Carpelos/Proyecto-Alicia/Caja Acrílica/pie.stl

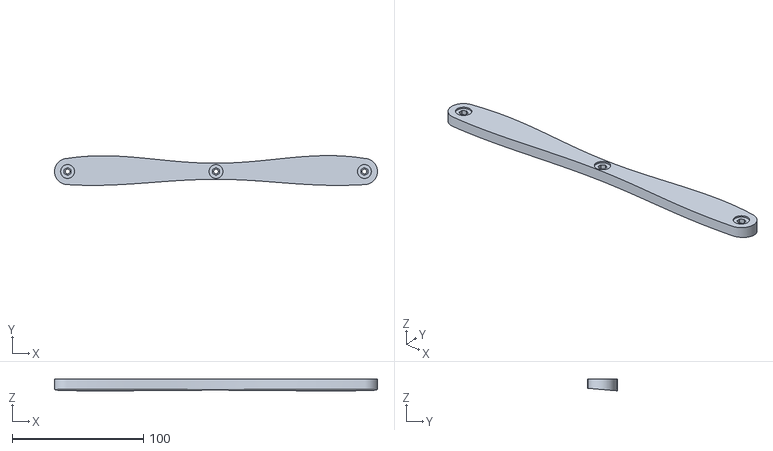
[picture p1: CAD file, 2020-08-05]
Caja Acrílica/pie.stl
246.2 x 22.7 x 8.98
