Carpelos/Proyecto-Alicia/Caja Acrílica/Poverty Alice_2_Plate.dxf

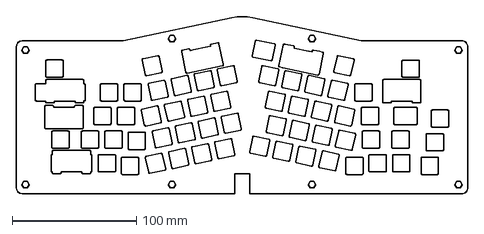
[picture p2: CAD file, 2020-07-27]
Caja Acrílica/Poverty Alice_2_Plate.dxf
364.2 x 143.2 mm
