Carpelos/Proyecto-Alicia/(list of files, cad)

Other CAD files:
Caja Acrílica/Caja Alicia.dwg
Caja Acrílica/bottom.dwg
Caja Acrílica/Poverty Alice_2 en plancha de 1216x660.dwg
Caja Acrílica/Poverty Alice_2.dwg
Caja Acrílica/Poverty Alice_2_Plate.dwg
