Carpelos/Proyecto-Alicia/pcb/Proyecto A.kicad_pcb

## KiCad design pcb/Proyecto A.kicad_pcb (2020-07-28)

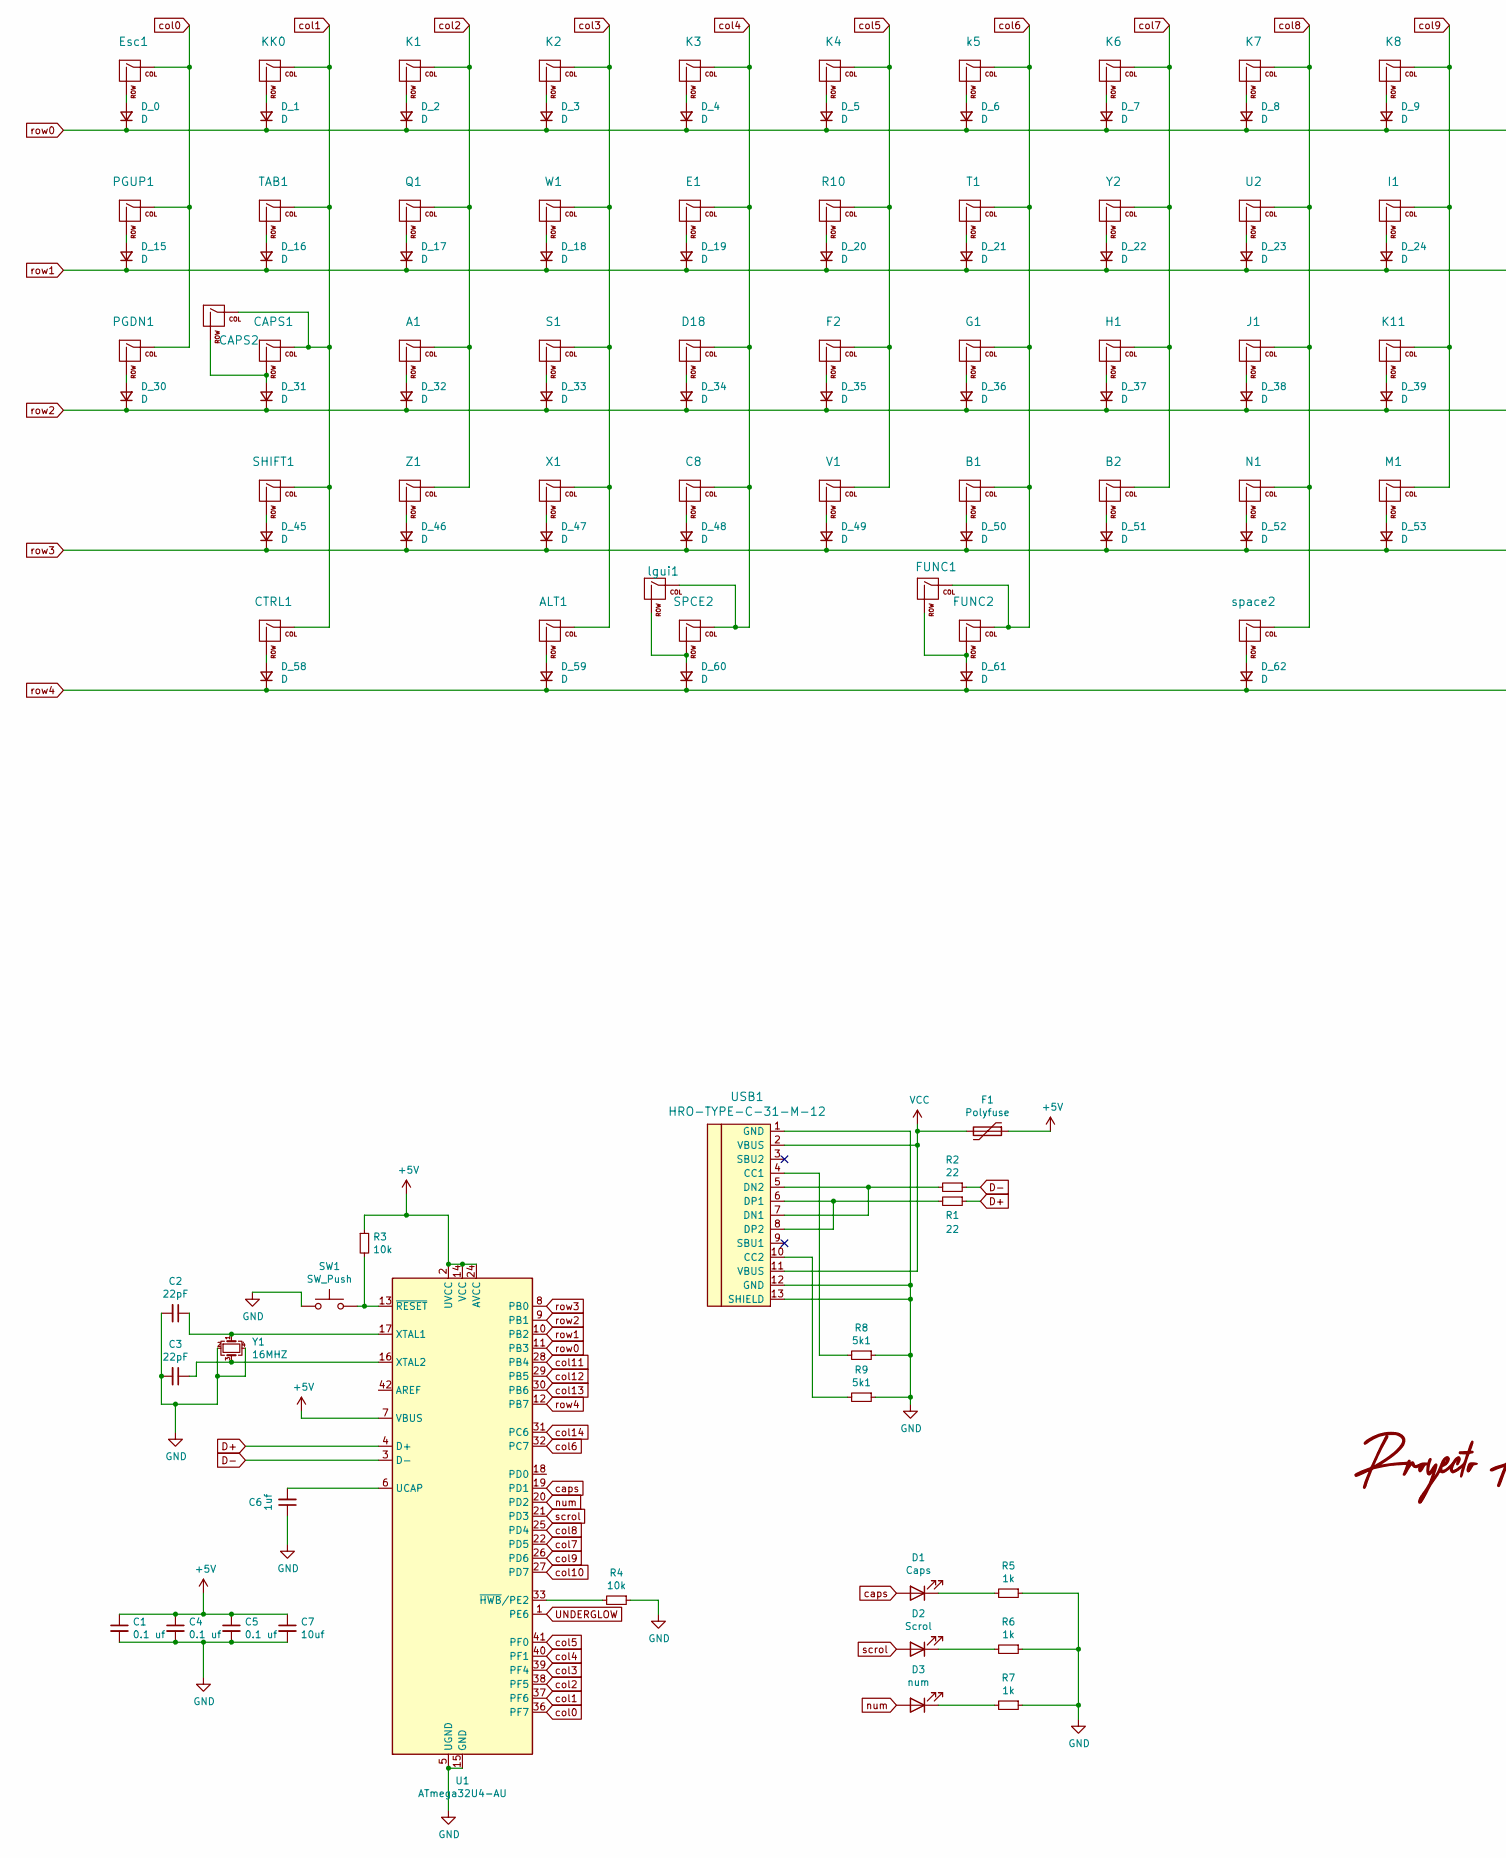
[picture p3: schematic Proyecto A.sch, part in row 1, column 1]

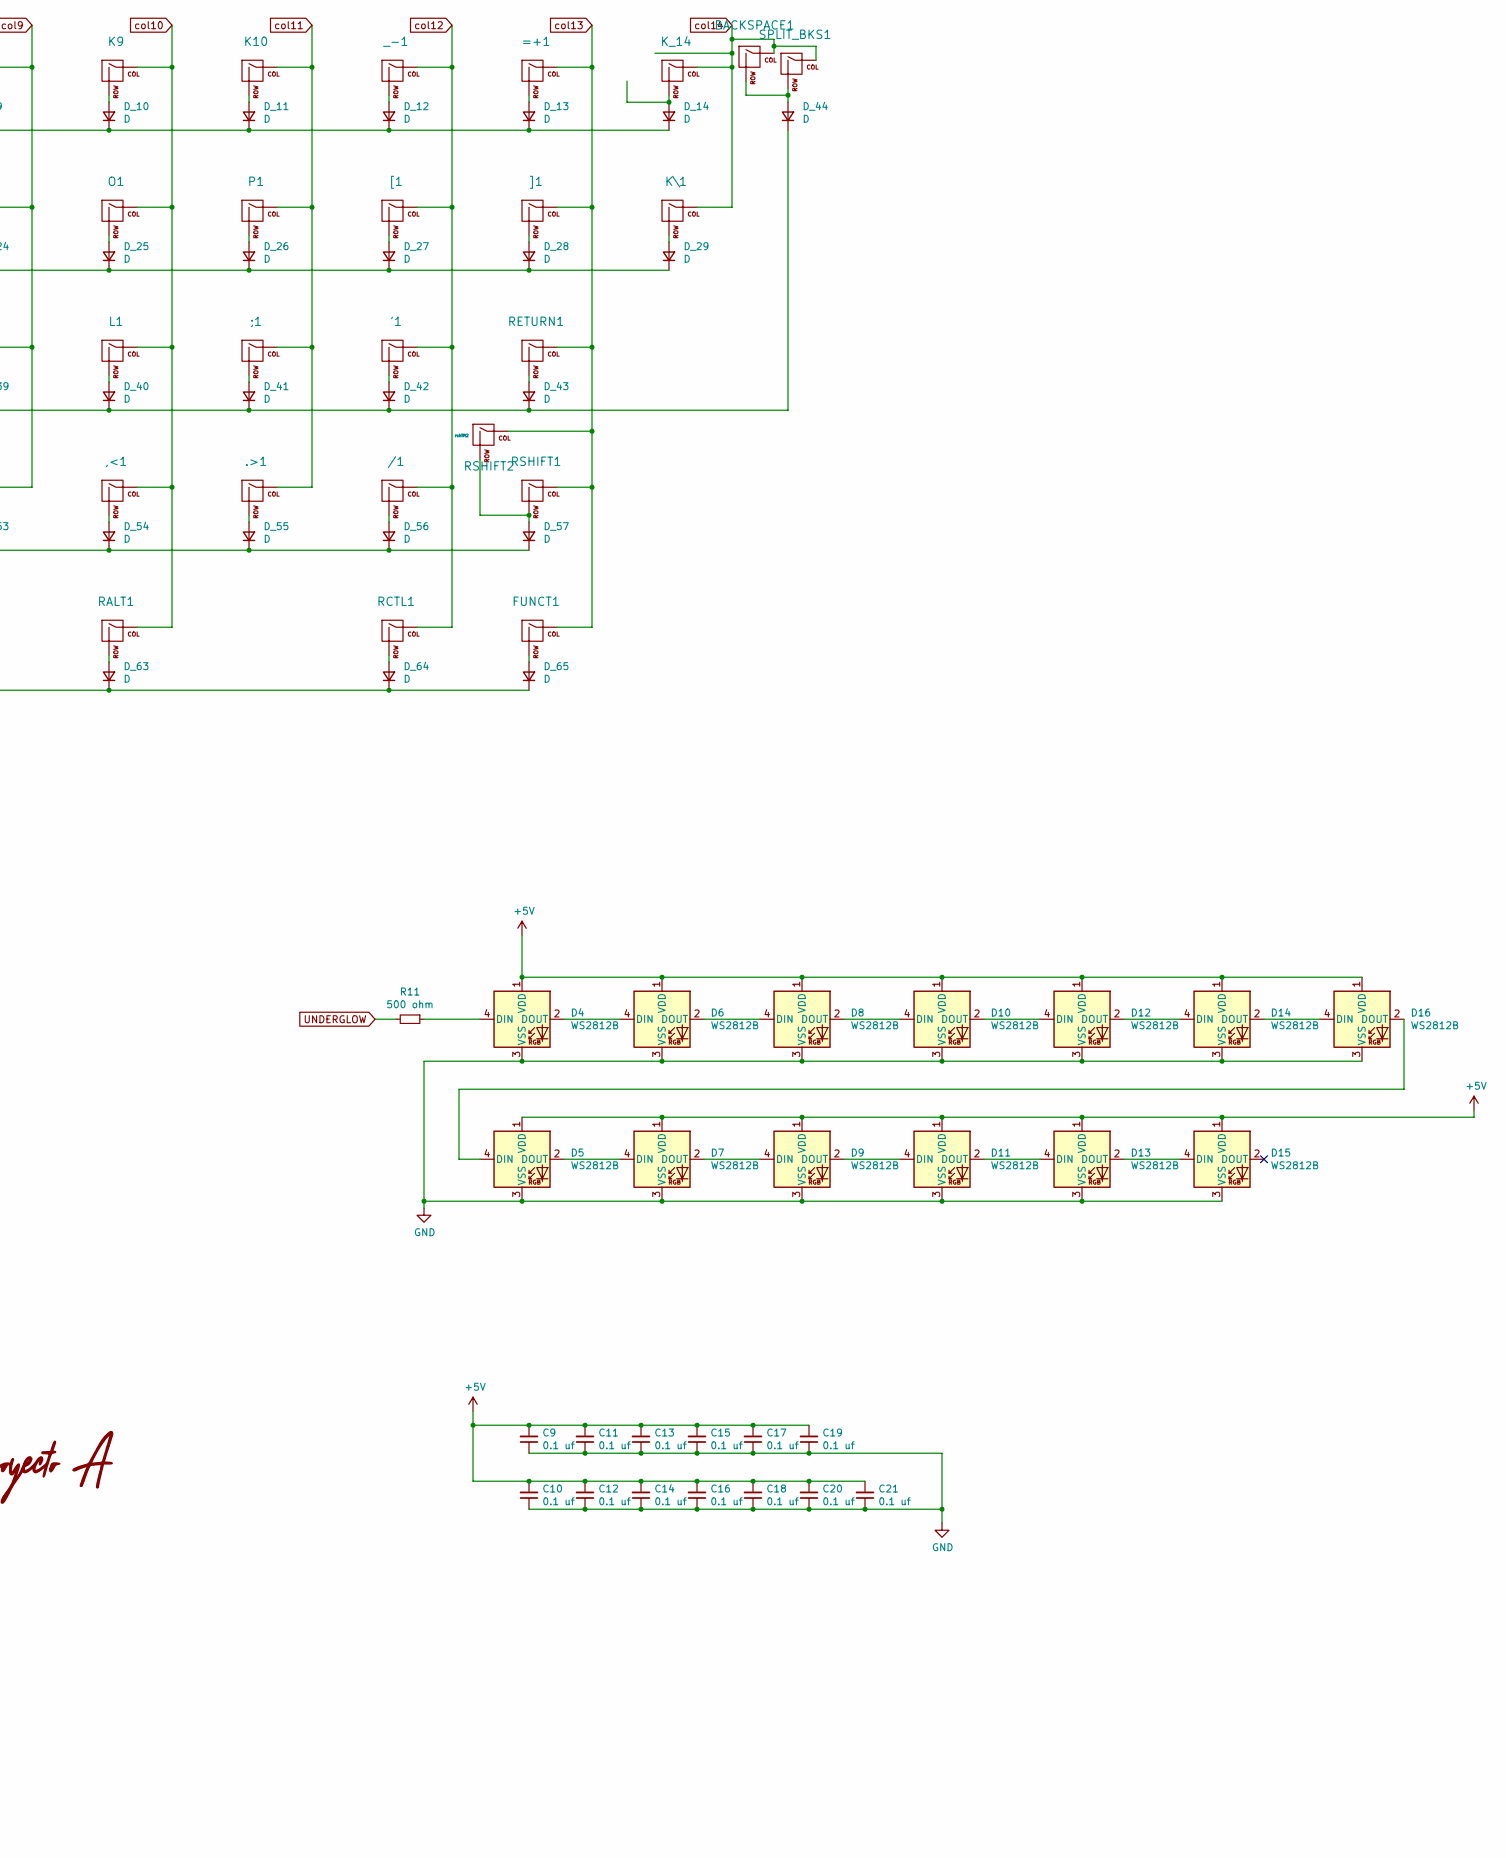
[picture p4: schematic Proyecto A.sch, part in row 1, column 2]

Parts:
'1: '; MXOnly-1U-NoLED
,<1: ,<; MXOnly-1U-NoLED
.>1: .>; MXOnly-1U-NoLED
/1: /; MXOnly-1U-NoLED
;1: ;; MXOnly-1U-NoLED
=+1: =; MXOnly-1U-NoLED
A1: a; MXOnly-1U-NoLED
ALT1: lalt; MXOnly-1.5U-NoLED
B1: b; MXOnly-1U-NoLED
B2: b2; MXOnly-1U-NoLED
BACKSPACE1: backspace; MXOnly-2U-NoLED
C1, C4, C5, C9, C10, C11, C12, C13, C14, C15, C16, C17, C18, C19, C20, C21: 0.1 uf; C_0805_2012Metric_Pad1.15x1.40mm_HandSolder
C2, C3: 22pF; C_0805_2012Metric_Pad1.15x1.40mm_HandSolder
C6: 1uf; C_0805_2012Metric_Pad1.15x1.40mm_HandSolder
C7: 10uf; C_0805_2012Metric_Pad1.15x1.40mm_HandSolder
C8: c; MXOnly-1U-NoLED
CAPS1: caps1; MXOnly-1.75U-NoLED
CAPS2: stcaps; MXOnly-1U-NoLED
CTRL1: lctrl; MXOnly-1.5U-NoLED
D1: Caps; LED_1206_3216Metric_Pad1.42x1.75mm_HandSolder
D2: Scrol; LED_1206_3216Metric_Pad1.42x1.75mm_HandSolder
D3: num; LED_1206_3216Metric_Pad1.42x1.75mm_HandSolder
D4, D5, D6, D7, D8, D9, D10, D11, D12, D13, D14, D15, D16: WS2812B; LED_WS2812B_PLCC4_5.0x5.0mm_P3.2mm
D18: d; MXOnly-1U-NoLED
D_0, D_1, D_2, D_3, D_4, D_5, D_6, D_7, D_8, D_9, D_10, D_11, D_12, D_13, D_14, D_15, D_16, D_17, D_18, D_19, D_20, D_21, D_22, D_23, D_24, D_25, D_26, D_27, D_28, D_29, D_30, D_31, D_32, D_33, D_34, D_35, D_36, D_37, D_38, D_39, D_40, D_41, D_42, D_43, D_44, D_45, D_46, D_47, D_48, D_49, D_50, D_51, D_52, D_53, D_54, D_55, D_56, D_57, D_58, D_59, D_60, D_61, D_62, D_63, D_64, D_65: D; D_SOD-123; JLC C64898
E1: e; MXOnly-1U-NoLED
Esc1: KEYSW; MXOnly-1U-NoLED
F1: Polyfuse; Fuse_1206_3216Metric
F2: f; MXOnly-1U-NoLED
FUNC1: func1; MXOnly-1U-NoLED
FUNC2: func1-2; MXOnly-1.25U-NoLED
FUNCT1: FUNC3; MXOnly-1U-NoLED
G1: g; MXOnly-1U-NoLED
H1: h; MXOnly-1U-NoLED
I1: i; MXOnly-1U-NoLED
J1: j; MXOnly-1U-NoLED
K1: 1; MXOnly-1U-NoLED
K2: 2; MXOnly-1U-NoLED
K3: 3; MXOnly-1U-NoLED
K4: 4; MXOnly-1U-NoLED
K6: 6; MXOnly-1U-NoLED
K7: 7; MXOnly-1U-NoLED
K8: 8; MXOnly-1U-NoLED
K9: 9; MXOnly-1U-NoLED
K10: 10; MXOnly-1U-NoLED
K11: k; MXOnly-1U-NoLED
KK0: ES; MXOnly-1U-NoLED
K\1: \\|; MXOnly-1U-NoLED
K_14: sbackspace; MXOnly-1U-NoLED
L1: l; MXOnly-1U-NoLED
M1: KEYSW; MXOnly-1U-NoLED
N1: n; MXOnly-1U-NoLED
O1: o; MXOnly-1U-NoLED
P1: p; MXOnly-1U-NoLED
PGDN1: KEYSW; MXOnly-1U-NoLED
PGUP1: pgup; MXOnly-1U-NoLED
Q1: q; MXOnly-1U-NoLED
R1, R2: 22; R_0805_2012Metric
R3, R4: 10k; R_0805_2012Metric
R5, R6, R7: 1k; R_0805_2012Metric
R8, R9: 5k1; R_0805_2012Metric
R10: r; MXOnly-1U-NoLED
R11: 500 ohm; R_0805_2012Metric_Pad1.15x1.40mm_HandSolder
RALT1: ralt; MXOnly-1.5U-NoLED
RCTL1: RCTRL; MXOnly-1.5U-NoLED
RETURN1: return; MXOnly-2.25U-ReversedStabilizers-NoLED
RSHIFT1: rshift1; MXOnly-1.75U-NoLED
RSHIFT2: rshift2; MXOnly-2.75U-NoLED
S1: s; MXOnly-1U-NoLED
SHIFT1: lshift; MXOnly-2.25U-NoLED
SPCE2: lgui2; MXOnly-2U-ReversedStabilizers-NoLED
SPLIT_BKS1: sbbackspace2; MXOnly-1U-NoLED
SW1: SW_Push; SW_SPST_SKQG_WithStem
T1: t; MXOnly-1U-NoLED
TAB1: tabulador; MXOnly-1.5U-NoLED
U1: ATmega32U4-AU; TQFP-44_10x10mm_P0.8mm
U2: u; MXOnly-1U-NoLED
USB1: HRO-TYPE-C-31-M-12; HRO-TYPE-C-31-M-12-HandSoldering
V1: v; MXOnly-1U-NoLED
W1: w; MXOnly-1U-NoLED
X1: x; MXOnly-1U-NoLED
Y1: 16MHZ; Crystal_SMD_3225-4Pin_3.2x2.5mm_HandSoldering
Y2: y; MXOnly-1U-NoLED
Z1: z; MXOnly-1U-NoLED
[1: [; MXOnly-1U-NoLED
]1: ]; MXOnly-1U-NoLED
_-1: -; MXOnly-1U-NoLED
k5: 5; MXOnly-1U-NoLED
lgui1: lgui; MXOnly-2.25U-ReversedStabilizers-NoLED
space2: KEYSW; MXOnly-2.75U-ReversedStabilizers-NoLED

Connections:
+5V: C1.1, C4.1, C5.1, C7.1, C9.2, C10.2, C11.2, C12.2, C13.2, C14.2, C15.2, C16.2, C17.2, C18.2, C19.2, C20.2, C21.2, D4.1 (VDD), D5.1 (VDD), D6.1 (VDD), D7.1 (VDD), D8.1 (VDD), D9.1 (VDD), D10.1 (VDD), D11.1 (VDD), D12.1 (VDD), D13.1 (VDD), D14.1 (VDD), D15.1 (VDD), D16.1 (VDD), F1.1, R3.1, U1.2 (UVCC), U1.7 (VBUS), U1.14 (VCC), U1.24 (AVCC), U1.34 (VCC), U1.44 (AVCC)
D+: R1.1, U1.4 (D+)
D-: R2.1, U1.3 (D-)
GND: C1.2, C2.2, C3.2, C4.2, C5.2, C6.1, C7.2, C9.1, C10.1, C11.1, C12.1, C13.1, C14.1, C15.1, C16.1, C17.1, C18.1, C19.1, C20.1, C21.1, D4.3 (VSS), D5.3 (VSS), D6.3 (VSS), D7.3 (VSS), D8.3 (VSS), D9.3 (VSS), D10.3 (VSS), D11.3 (VSS), D12.3 (VSS), D13.3 (VSS), D14.3 (VSS), D15.3 (VSS), D16.3 (VSS), R4.1, R5.1, R6.1, R7.1, R8.1, R9.1, SW1.1, U1.5 (UGND), U1.15 (GND), U1.23 (GND), U1.35 (GND), U1.43 (GND), USB1.1 (GND), USB1.12 (GND), USB1.13 (SHIELD), Y1.2, Y1.4
unnamed: '1.2 (ROW), D_42.2 (A)
unnamed: ,<1.2 (ROW), D_54.2 (A)
unnamed: .>1.2 (ROW), D_55.2 (A)
unnamed: /1.2 (ROW), D_56.2 (A)
unnamed: ;1.2 (ROW), D_41.2 (A)
unnamed: =+1.2 (ROW), D_13.2 (A)
unnamed: A1.2 (ROW), D_32.2 (A)
unnamed: ALT1.2 (ROW), D_59.2 (A)
unnamed: B1.2 (ROW), D_50.2 (A)
unnamed: B2.2 (ROW), D_51.2 (A)
unnamed: BACKSPACE1.2 (ROW), D_44.2 (A), SPLIT_BKS1.2 (ROW)
unnamed: C2.1, U1.17 (XTAL1), Y1.1
unnamed: C3.1, U1.16 (XTAL2), Y1.3
unnamed: C6.2, U1.6 (UCAP)
unnamed: C8.2 (ROW), D_48.2 (A)
unnamed: CAPS1.2 (ROW), CAPS2.2 (ROW), D_31.2 (A)
unnamed: CTRL1.2 (ROW), D_58.2 (A)
unnamed: D1.1 (K), R5.2
unnamed: D2.1 (K), R6.2
unnamed: D3.1 (K), R7.2
unnamed: D4.2 (DOUT), D6.4 (DIN)
unnamed: D4.4 (DIN), R11.1
unnamed: D5.2 (DOUT), D7.4 (DIN)
unnamed: D6.2 (DOUT), D8.4 (DIN)
unnamed: D7.2 (DOUT), D9.4 (DIN)
unnamed: D10.2 (DOUT), D12.4 (DIN)
unnamed: D8.2 (DOUT), D10.4 (DIN)
unnamed: D11.2 (DOUT), D13.4 (DIN)
unnamed: D9.2 (DOUT), D11.4 (DIN)
unnamed: D12.2 (DOUT), D14.4 (DIN)
unnamed: D13.2 (DOUT), D15.4 (DIN)
unnamed: D14.2 (DOUT), D16.4 (DIN)
unnamed: D5.4 (DIN), D16.2 (DOUT)
unnamed: D18.2 (ROW), D_34.2 (A)
unnamed: D_0.2 (A), Esc1.2 (ROW)
unnamed: D_1.2 (A), KK0.2 (ROW)
unnamed: D_2.2 (A), K1.2 (ROW)
unnamed: D_3.2 (A), K2.2 (ROW)
unnamed: D_4.2 (A), K3.2 (ROW)
unnamed: D_5.2 (A), K4.2 (ROW)
unnamed: D_6.2 (A), k5.2 (ROW)
unnamed: D_7.2 (A), K6.2 (ROW)
unnamed: D_8.2 (A), K7.2 (ROW)
unnamed: D_9.2 (A), K8.2 (ROW)
unnamed: D_10.2 (A), K9.2 (ROW)
unnamed: D_11.2 (A), K10.2 (ROW)
unnamed: D_12.2 (A), _-1.2 (ROW)
unnamed: D_14.2 (A), K_14.2 (ROW)
unnamed: D_15.2 (A), PGUP1.2 (ROW)
unnamed: D_16.2 (A), TAB1.2 (ROW)
unnamed: D_17.2 (A), Q1.2 (ROW)
unnamed: D_18.2 (A), W1.2 (ROW)
unnamed: D_19.2 (A), E1.2 (ROW)
unnamed: D_20.2 (A), R10.2 (ROW)
unnamed: D_21.2 (A), T1.2 (ROW)
unnamed: D_22.2 (A), Y2.2 (ROW)
unnamed: D_23.2 (A), U2.2 (ROW)
unnamed: D_24.2 (A), I1.2 (ROW)
unnamed: D_25.2 (A), O1.2 (ROW)
unnamed: D_26.2 (A), P1.2 (ROW)
unnamed: D_27.2 (A), [1.2 (ROW)
unnamed: D_28.2 (A), ]1.2 (ROW)
unnamed: D_29.2 (A), K\1.2 (ROW)
unnamed: D_30.2 (A), PGDN1.2 (ROW)
unnamed: D_33.2 (A), S1.2 (ROW)
unnamed: D_35.2 (A), F2.2 (ROW)
unnamed: D_36.2 (A), G1.2 (ROW)
unnamed: D_37.2 (A), H1.2 (ROW)
unnamed: D_38.2 (A), J1.2 (ROW)
unnamed: D_39.2 (A), K11.2 (ROW)
unnamed: D_40.2 (A), L1.2 (ROW)
unnamed: D_43.2 (A), RETURN1.2 (ROW)
unnamed: D_45.2 (A), SHIFT1.2 (ROW)
unnamed: D_46.2 (A), Z1.2 (ROW)
unnamed: D_47.2 (A), X1.2 (ROW)
unnamed: D_49.2 (A), V1.2 (ROW)
unnamed: D_52.2 (A), N1.2 (ROW)
unnamed: D_53.2 (A), M1.2 (ROW)
unnamed: D_57.2 (A), RSHIFT1.2 (ROW), RSHIFT2.2 (ROW)
unnamed: D_60.2 (A), SPCE2.2 (ROW), lgui1.2 (ROW)
unnamed: D_61.2 (A), FUNC1.2 (ROW), FUNC2.2 (ROW)
unnamed: D_62.2 (A), space2.2 (ROW)
unnamed: D_63.2 (A), RALT1.2 (ROW)
unnamed: D_64.2 (A), RCTL1.2 (ROW)
unnamed: D_65.2 (A), FUNCT1.2 (ROW)
unnamed: R1.2, USB1.6 (DP1), USB1.8 (DP2)
unnamed: R2.2, USB1.5 (DN2), USB1.7 (DN1)
unnamed: R3.2, SW1.2, U1.13 (~RESET)
unnamed: R4.2, U1.33 (~HWB~/PE2)
unnamed: R8.2, USB1.4 (CC1)
unnamed: R9.2, USB1.10 (CC2)
UNDERGLOW: R11.2, U1.1 (PE6)
VCC: F1.2, USB1.2 (VBUS), USB1.11 (VBUS)
caps: D1.2 (A), U1.19 (PD1)
col0: Esc1.1 (COL), PGDN1.1 (COL), PGUP1.1 (COL), U1.36 (PF7)
col1: CAPS1.1 (COL), CAPS2.1 (COL), CTRL1.1 (COL), KK0.1 (COL), SHIFT1.1 (COL), TAB1.1 (COL), U1.37 (PF6)
col2: A1.1 (COL), K1.1 (COL), Q1.1 (COL), U1.38 (PF5), Z1.1 (COL)
col3: ALT1.1 (COL), K2.1 (COL), S1.1 (COL), U1.39 (PF4), W1.1 (COL), X1.1 (COL)
col4: C8.1 (COL), D18.1 (COL), E1.1 (COL), K3.1 (COL), SPCE2.1 (COL), U1.40 (PF1), lgui1.1 (COL)
col5: F2.1 (COL), K4.1 (COL), R10.1 (COL), U1.41 (PF0), V1.1 (COL)
col6: B1.1 (COL), FUNC1.1 (COL), FUNC2.1 (COL), G1.1 (COL), T1.1 (COL), U1.32 (PC7), k5.1 (COL)
col7: B2.1 (COL), H1.1 (COL), K6.1 (COL), U1.22 (PD5), Y2.1 (COL)
col8: J1.1 (COL), K7.1 (COL), N1.1 (COL), U1.25 (PD4), U2.1 (COL), space2.1 (COL)
col9: I1.1 (COL), K8.1 (COL), K11.1 (COL), M1.1 (COL), U1.26 (PD6)
col10: ,<1.1 (COL), K9.1 (COL), L1.1 (COL), O1.1 (COL), RALT1.1 (COL), U1.27 (PD7)
col11: .>1.1 (COL), ;1.1 (COL), K10.1 (COL), P1.1 (COL), U1.28 (PB4)
col12: '1.1 (COL), /1.1 (COL), RCTL1.1 (COL), U1.29 (PB5), [1.1 (COL), _-1.1 (COL)
col13: =+1.1 (COL), FUNCT1.1 (COL), RETURN1.1 (COL), RSHIFT1.1 (COL), RSHIFT2.1 (COL), U1.30 (PB6), ]1.1 (COL)
col14: BACKSPACE1.1 (COL), K\1.1 (COL), K_14.1 (COL), SPLIT_BKS1.1 (COL), U1.31 (PC6)
num: D3.2 (A), U1.20 (PD2)
row0: D_0.1 (K), D_1.1 (K), D_2.1 (K), D_3.1 (K), D_4.1 (K), D_5.1 (K), D_6.1 (K), D_7.1 (K), D_8.1 (K), D_9.1 (K), D_10.1 (K), D_11.1 (K), D_12.1 (K), D_13.1 (K), D_14.1 (K), U1.11 (PB3)
row1: D_15.1 (K), D_16.1 (K), D_17.1 (K), D_18.1 (K), D_19.1 (K), D_20.1 (K), D_21.1 (K), D_22.1 (K), D_23.1 (K), D_24.1 (K), D_25.1 (K), D_26.1 (K), D_27.1 (K), D_28.1 (K), D_29.1 (K), U1.10 (PB2)
row2: D_30.1 (K), D_31.1 (K), D_32.1 (K), D_33.1 (K), D_34.1 (K), D_35.1 (K), D_36.1 (K), D_37.1 (K), D_38.1 (K), D_39.1 (K), D_40.1 (K), D_41.1 (K), D_42.1 (K), D_43.1 (K), D_44.1 (K), U1.9 (PB1)
row3: D_45.1 (K), D_46.1 (K), D_47.1 (K), D_48.1 (K), D_49.1 (K), D_50.1 (K), D_51.1 (K), D_52.1 (K), D_53.1 (K), D_54.1 (K), D_55.1 (K), D_56.1 (K), D_57.1 (K), U1.8 (PB0)
row4: D_58.1 (K), D_59.1 (K), D_60.1 (K), D_61.1 (K), D_62.1 (K), D_63.1 (K), D_64.1 (K), D_65.1 (K), U1.12 (PB7)
scrol: D2.2 (A), U1.21 (PD3)

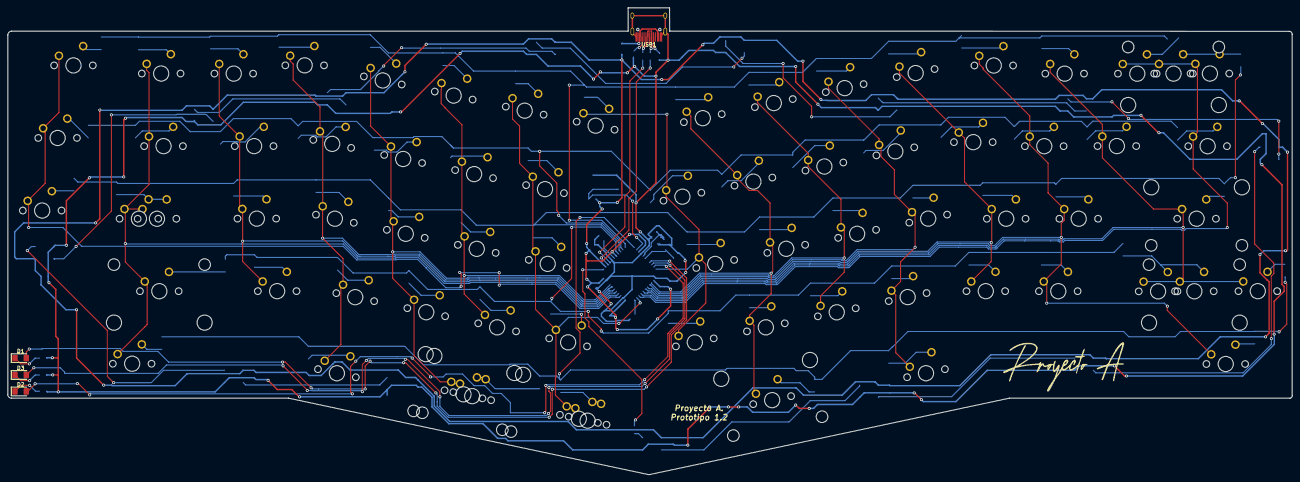
[picture p5: board Proyecto A.kicad_pcb from above]

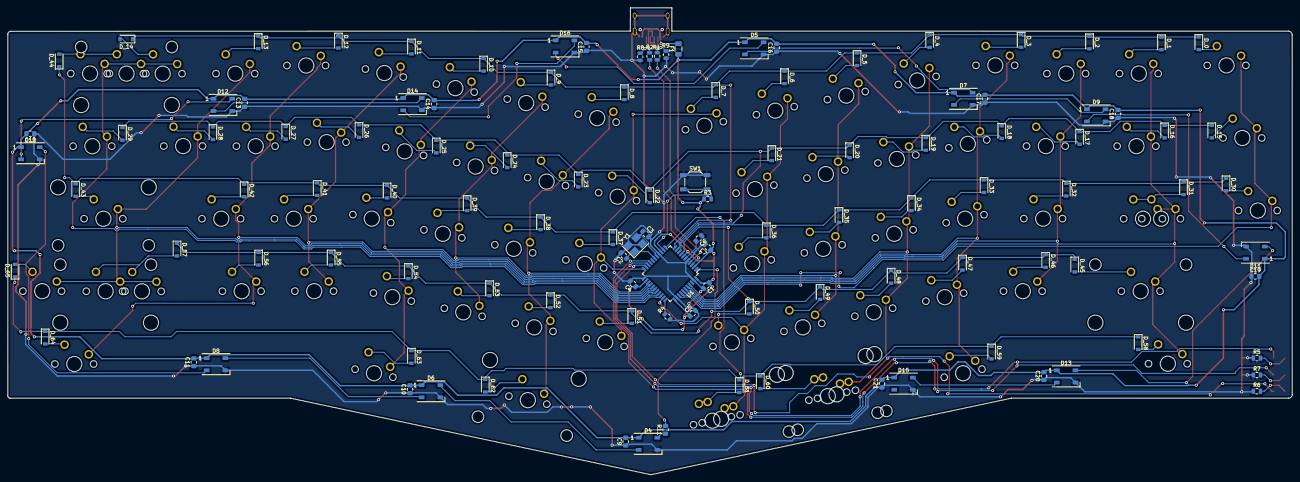
[picture p6: board Proyecto A.kicad_pcb from below]

Board: 2 copper layers, 337.3 x 122.6 mm, 188 parts (113 on the bottom side), 120 nets.
