Carpelos/Proyecto-Alicia/(commit log)

2020-07-18 added a 500 ohm resistor bettween mcu underglow pin and 1st ws2812b
    [Proyecto A.kicad_pcb, Proyecto A.sch]
2020-07-27 Proto 1.1
    [Keyboard.sch, Poverty Alice_2 en plancha de 1216x660.dwg, Poverty Alice_2.dwg, Poverty Alice_2.dxf, Poverty Alice_2_Plate.dwg, Poverty Alice_2_Plate.dxf, PovertyAlice Atmega.sch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]
2020-07-28 proto 1.2
    Moved usb to top side of the pcb
    [Proyecto A-B_Cu.gbr, Proyecto A-B_Mask.gbr, Proyecto A-B_Paste.gbr, Proyecto A-B_SilkS.gbr, Proyecto A-Edge_Cuts.gbr, Proyecto A-F_Cu.gbr, Proyecto A-F_Mask.gbr, Proyecto A-F_Paste.gbr]
2020-08-05 Acrylic Case updated
    [Caja Alicia.dwg, bottom.dwg, pie.stl]
2020-08-09 updated plate.
2020-08-10 qmk firmware
    [Caja Alicia.dwg]
2020-08-29 Caja acrílica y cambios en la PCB
    [Caja Alicia.dwg]
